BastianRu/Proyecto_Monitor_Ambiental/Diagrama_De_Flujo.pdf

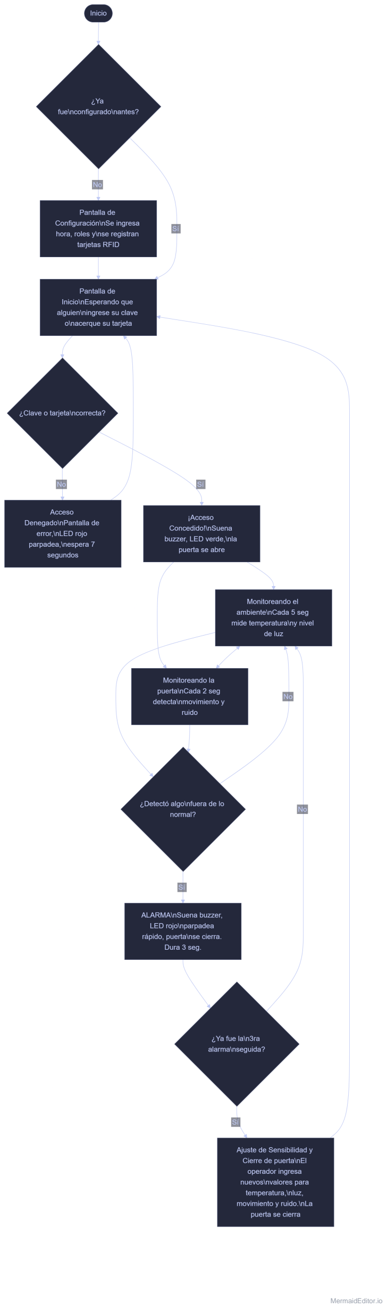
[picture p8: page 1]

MermaidEditor.io
