BastianRu/Proyecto_Monitor_Ambiental/Diagrama_De_Flujo.png

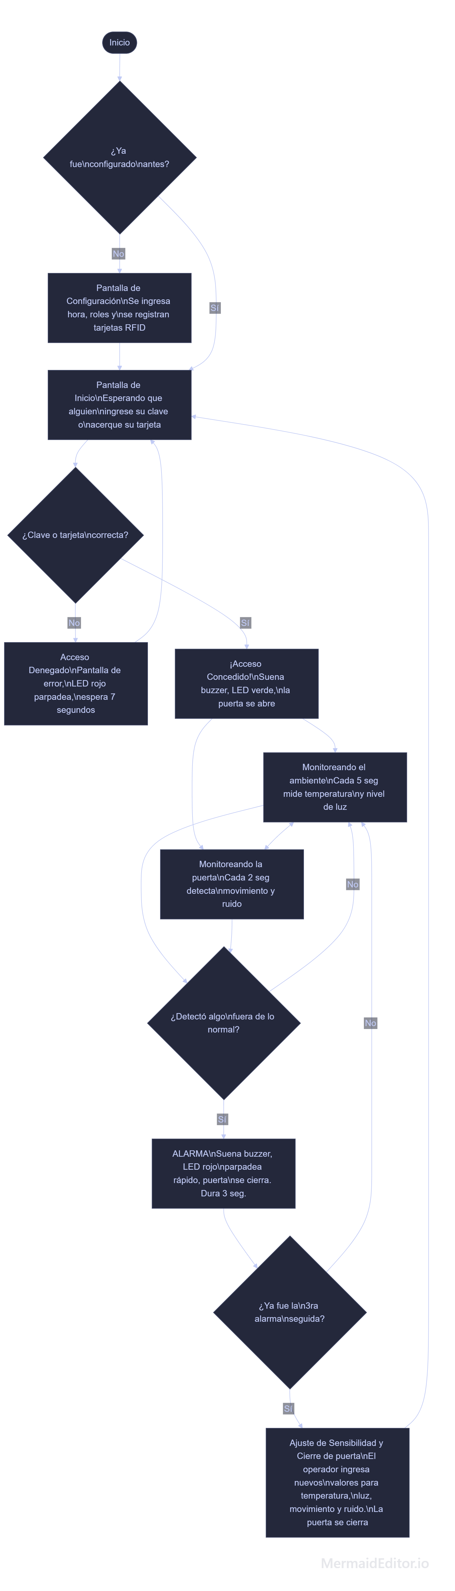
Diagrama_De_Flujo.png
