BastianRu/Proyecto_Monitor_Ambiental/FSM.png

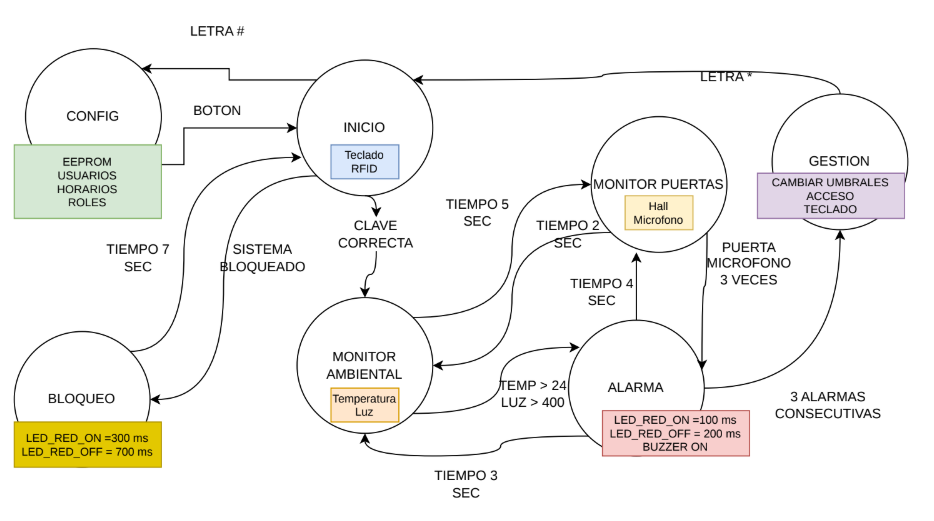
FSM.png
